KubaVymola/JFP_board_v2/schematic/JFP_board_v2_pcb_screenshot.png

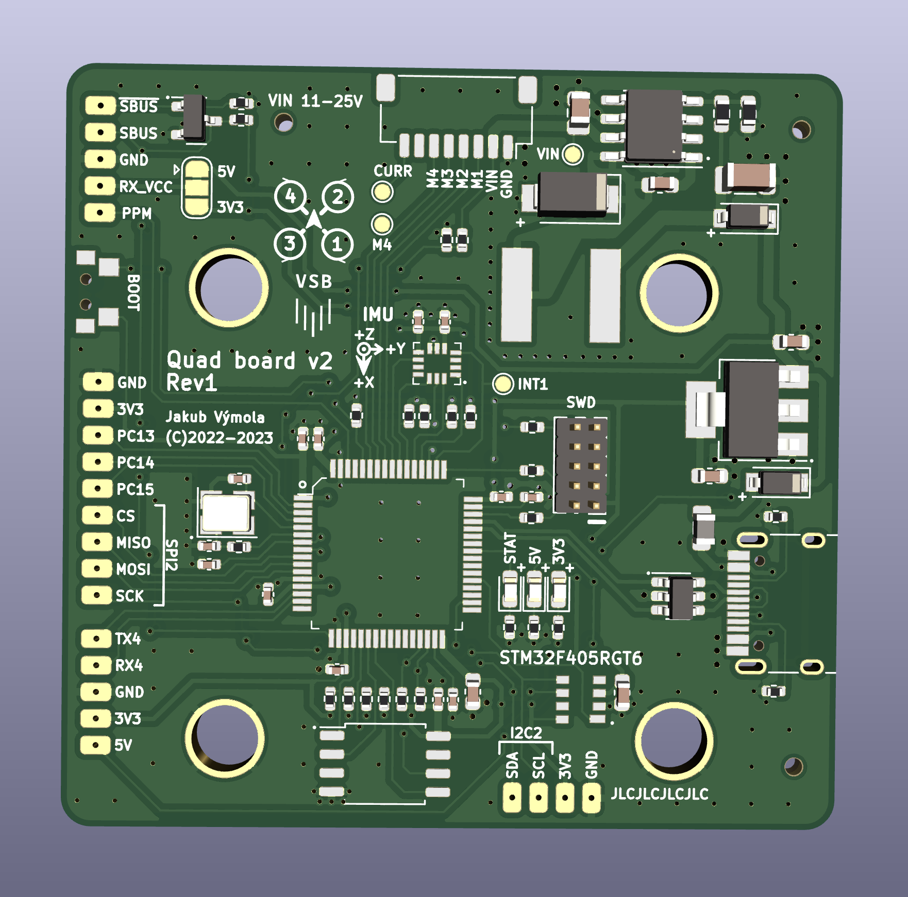
schematic/JFP_board_v2_pcb_screenshot.png
