KubaVymola/JFP_board_v2/orders/pcb_vym0038_13_1_2023.pdf

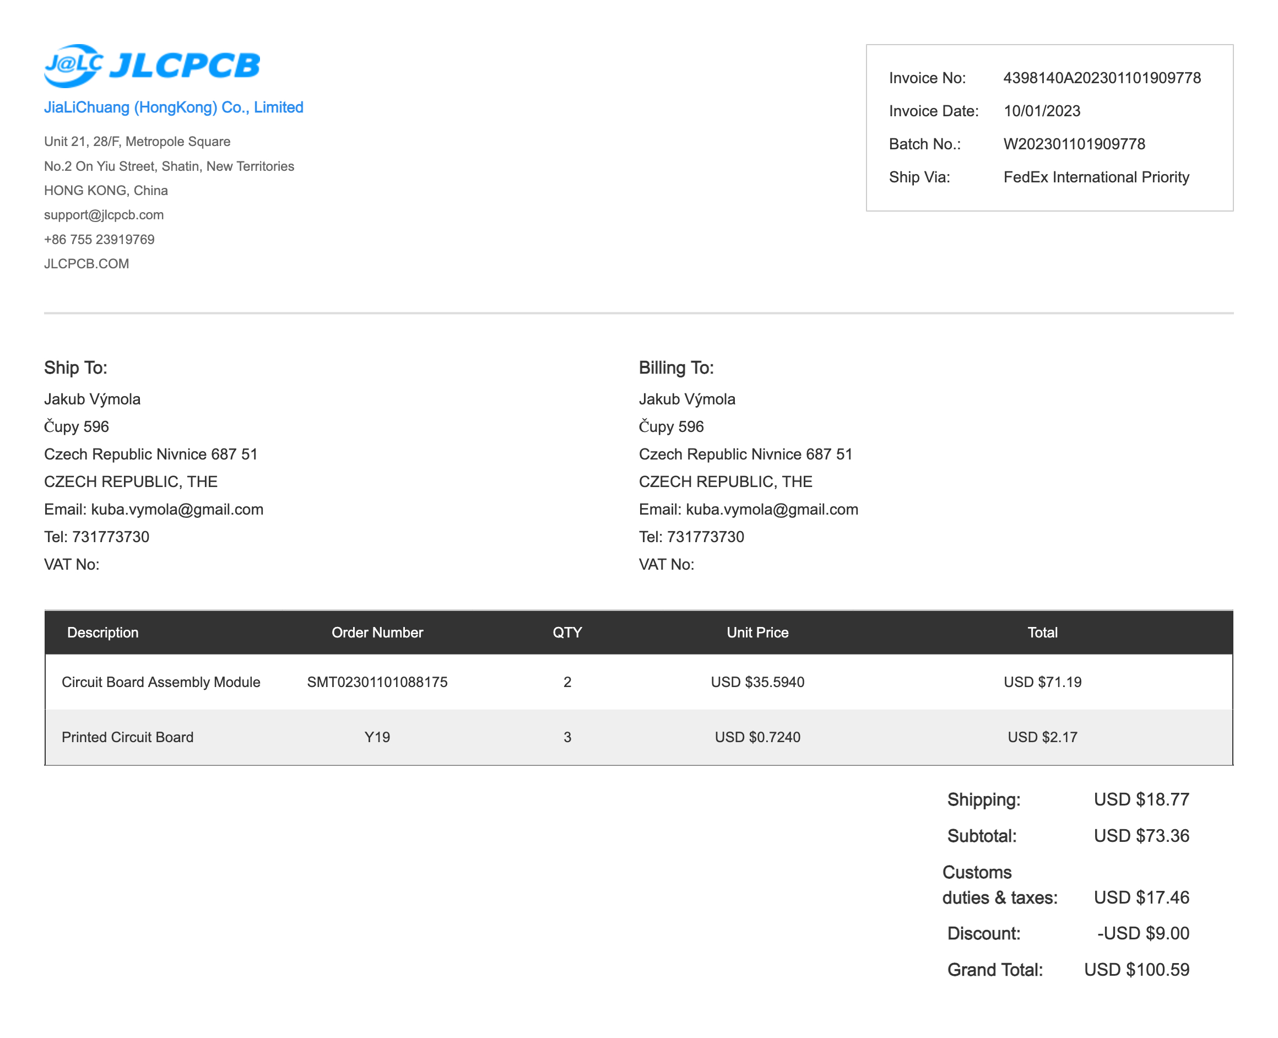
[picture p2: figure]
