KubaVymola/JFP_board_v2/schematic/JFP_board_v2.pdf

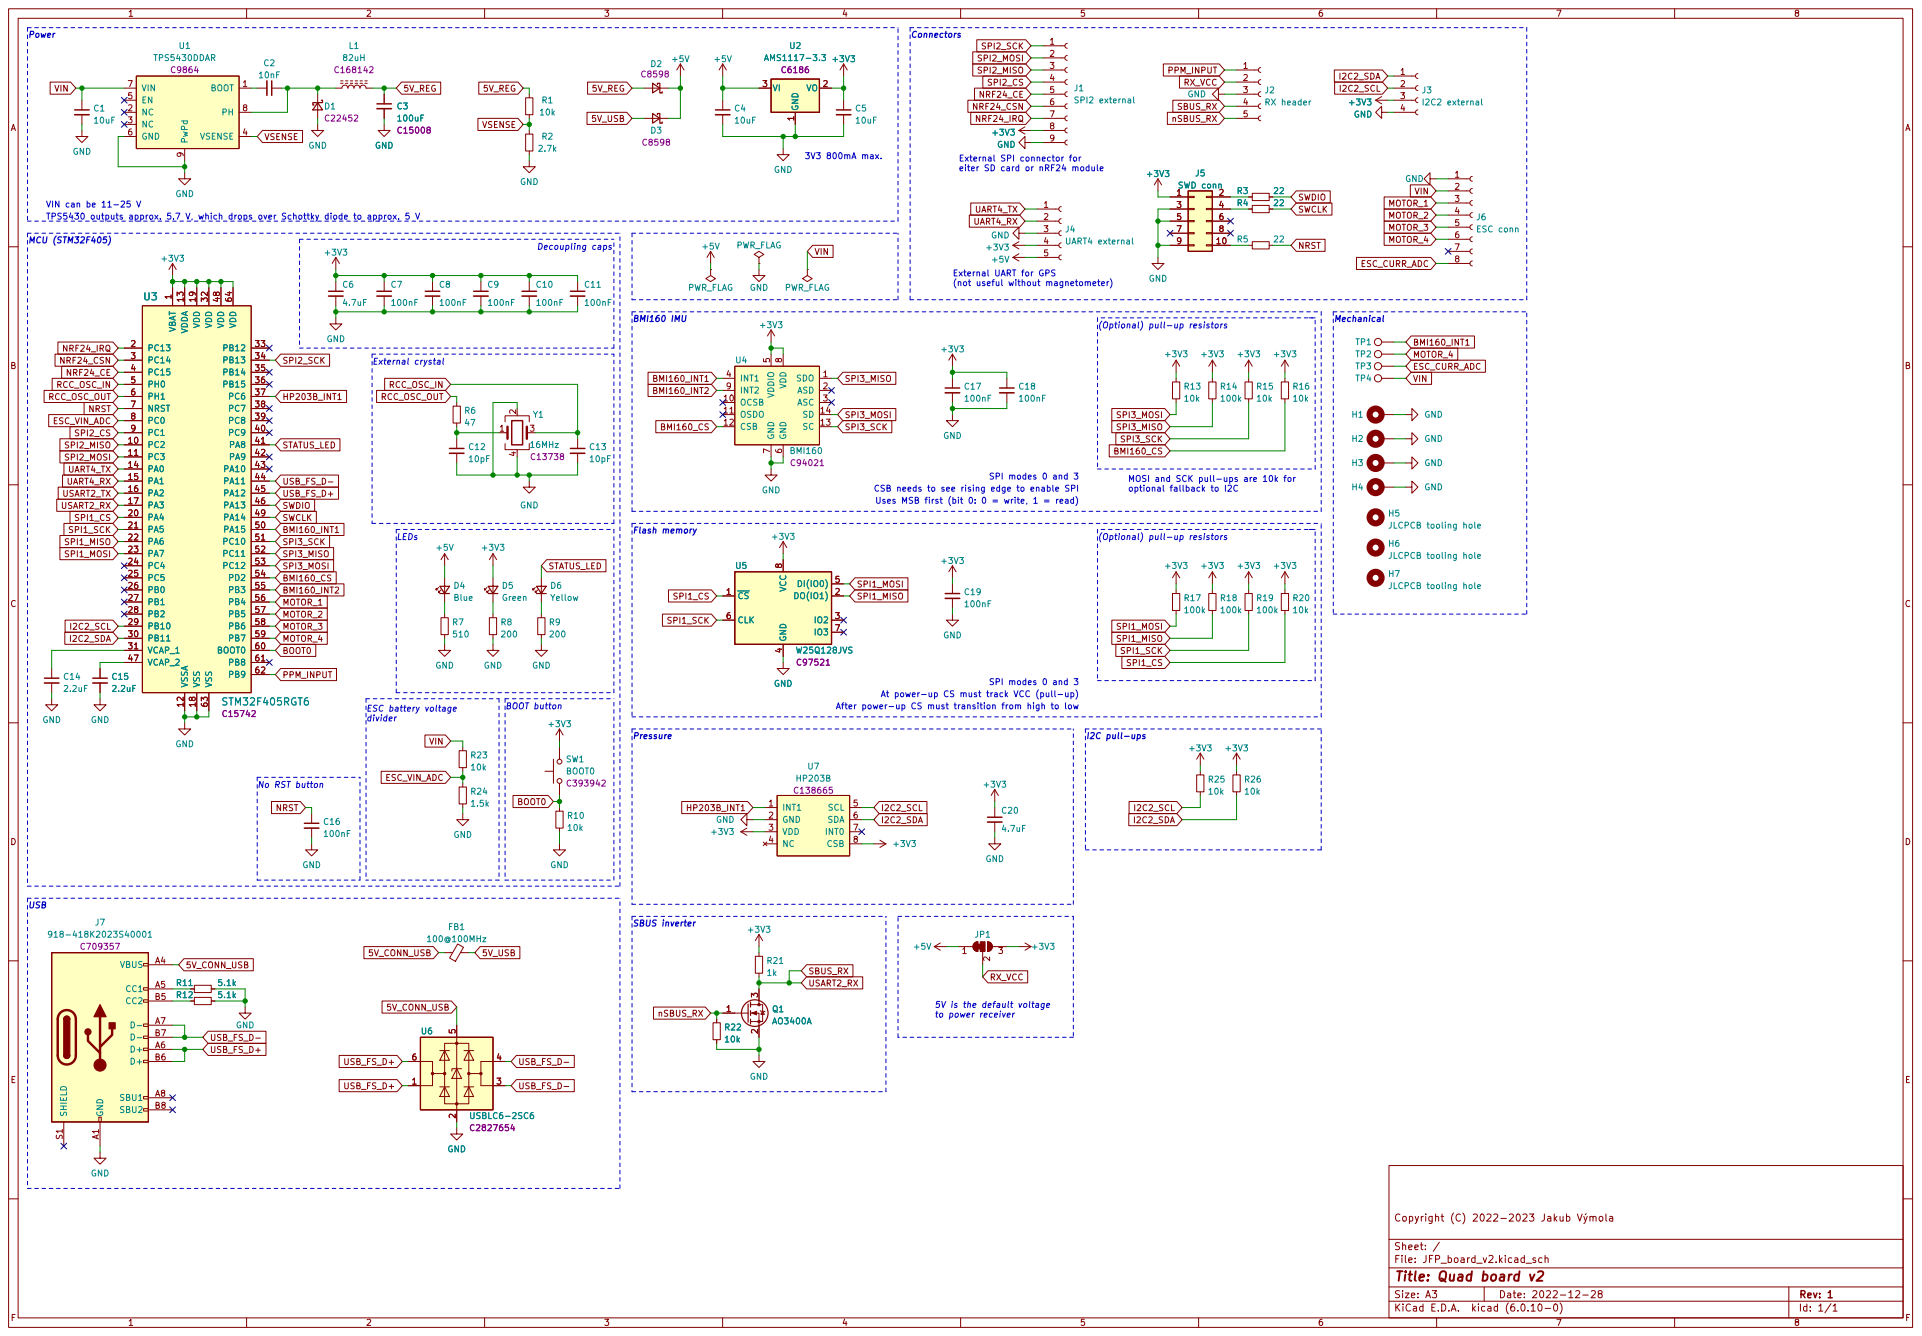
[picture p3: page 1]

1 VO 2 VI 3 +3V3 U5 W25Q128JVS C97521 ~{CS} 1 DO(IO1) 2

(not useful without magnetometer) External SPI connector for eiter SD card or nRF24 module CSB needs to see rising edge to enable SPI SPI modes 0 and 3

1 PC2 10 PC3 11 VSSA 12 VDDA 13 PA0 14 PA1 15 PA2 16 PA3 17 VSS 18 VDD 19 PC13 2 PA4 20 PA5 21 PA6 22 PA7 23 PC4 24 PC5 25 PB0 26 PB1 27 PB2 28 PB10 29 PC14 3 PB11 30 VCAP_1 31 VDD 32 PB12 33 PB13 34 PB14 35 PB15 36 PC6 37 PC7 38 PC8 39 PC15 4 PC9 40 PA8 41 PA9 42 PA10 43 PA11 44 PA12 45 PA13 46 VCAP_2 47 VDD 48 PA14 49 PH0 5 PA15 50 PC10 51 PC11 52 PC12 53 PD2 54 PB3 55 PB4 56 PB5 57 PB6 58 PB7 59 PH1 6 BOOT0 60 PB8 61 PB9 62 VSS 63 VDD 64 NRST 7 PC0 8 PC1 9 C3

VIN can be 11-25 V
TPS5430 outputs approx. 5.7 V, which drops over Schottky diode to approx. 5 V

5 5 | 6 6 R5 22
7 7 | 8 8

Uses MSB first (bit 0: 0 = write, 1 = read) External UART for GPS

1 PC2 10 PC3 11 VSSA 12 VDDA 13 PA0 14 PA1 15 PA2 16 PA3 17 VSS 18 VDD 19 PC13 2 PA4 20 PA5 21 PA6 22 PA7 23 PC4 24 PC5 25 PB0 26 PB1 27 PB2 28 PB10 29 PC14 3 PB11 30 VCAP_1 31 VDD 32 PB12 33 PB13 34 PB14 35 PB15 36 PC6 37 PC7 38 PC8 39 PC15 4 PC9 40 PA8 41 PA9 42 PA10 43 PA11 44 PA12 45 PA13 46 VCAP_2 47 VDD 48 PA14 49 PH0 5 PA15 50 PC10 51 PC11 52 PC12 53 PD2 54 PB3 55 PB4 56 PB5 57 PB6 58 PB7 59 PH1 6 BOOT0 60 PB8 61 PB9 62 VSS 63 VDD 64 NRST 7 PC0 8 PC1 9 U3 STM32F405RGT6 C15742

(Optional) pull-up resistors

5 GND
LEDs ESC battery voltage

MOSI and SCK pull-ups are 10k for
optional fallback to I2C

At power-up CS must track VCC (pull-up)

After power-up CS must transition from high to low

divider ESC_VIN_ADC | 1.5k GND | BOOT0

NRST

5V is the default voltage
to power receiver

Id: 1/1 Title: Quad board v2
