KubaVymola/JFP_board_v2/schematic/JFP_board_v2_pcb.pdf

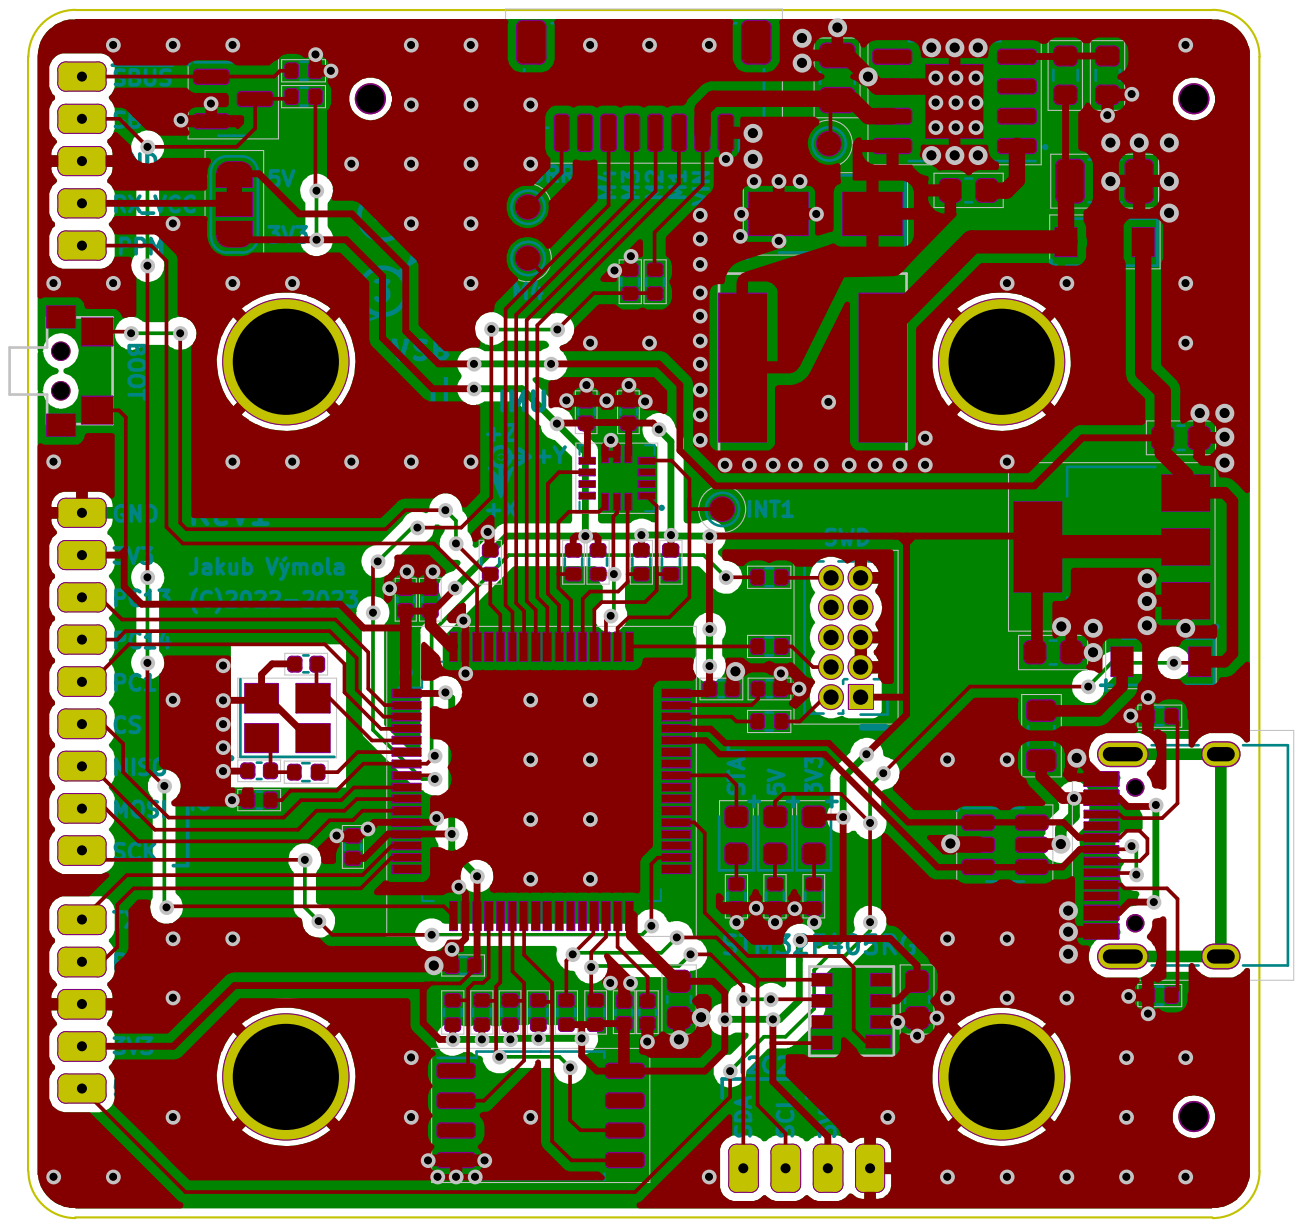
[picture p4: page 1]
