KubaVymola/JFP_board_v2/JFP_board_v2.kicad_pcb

## KiCad design JFP_board_v2.kicad_pcb (2023-02-23)

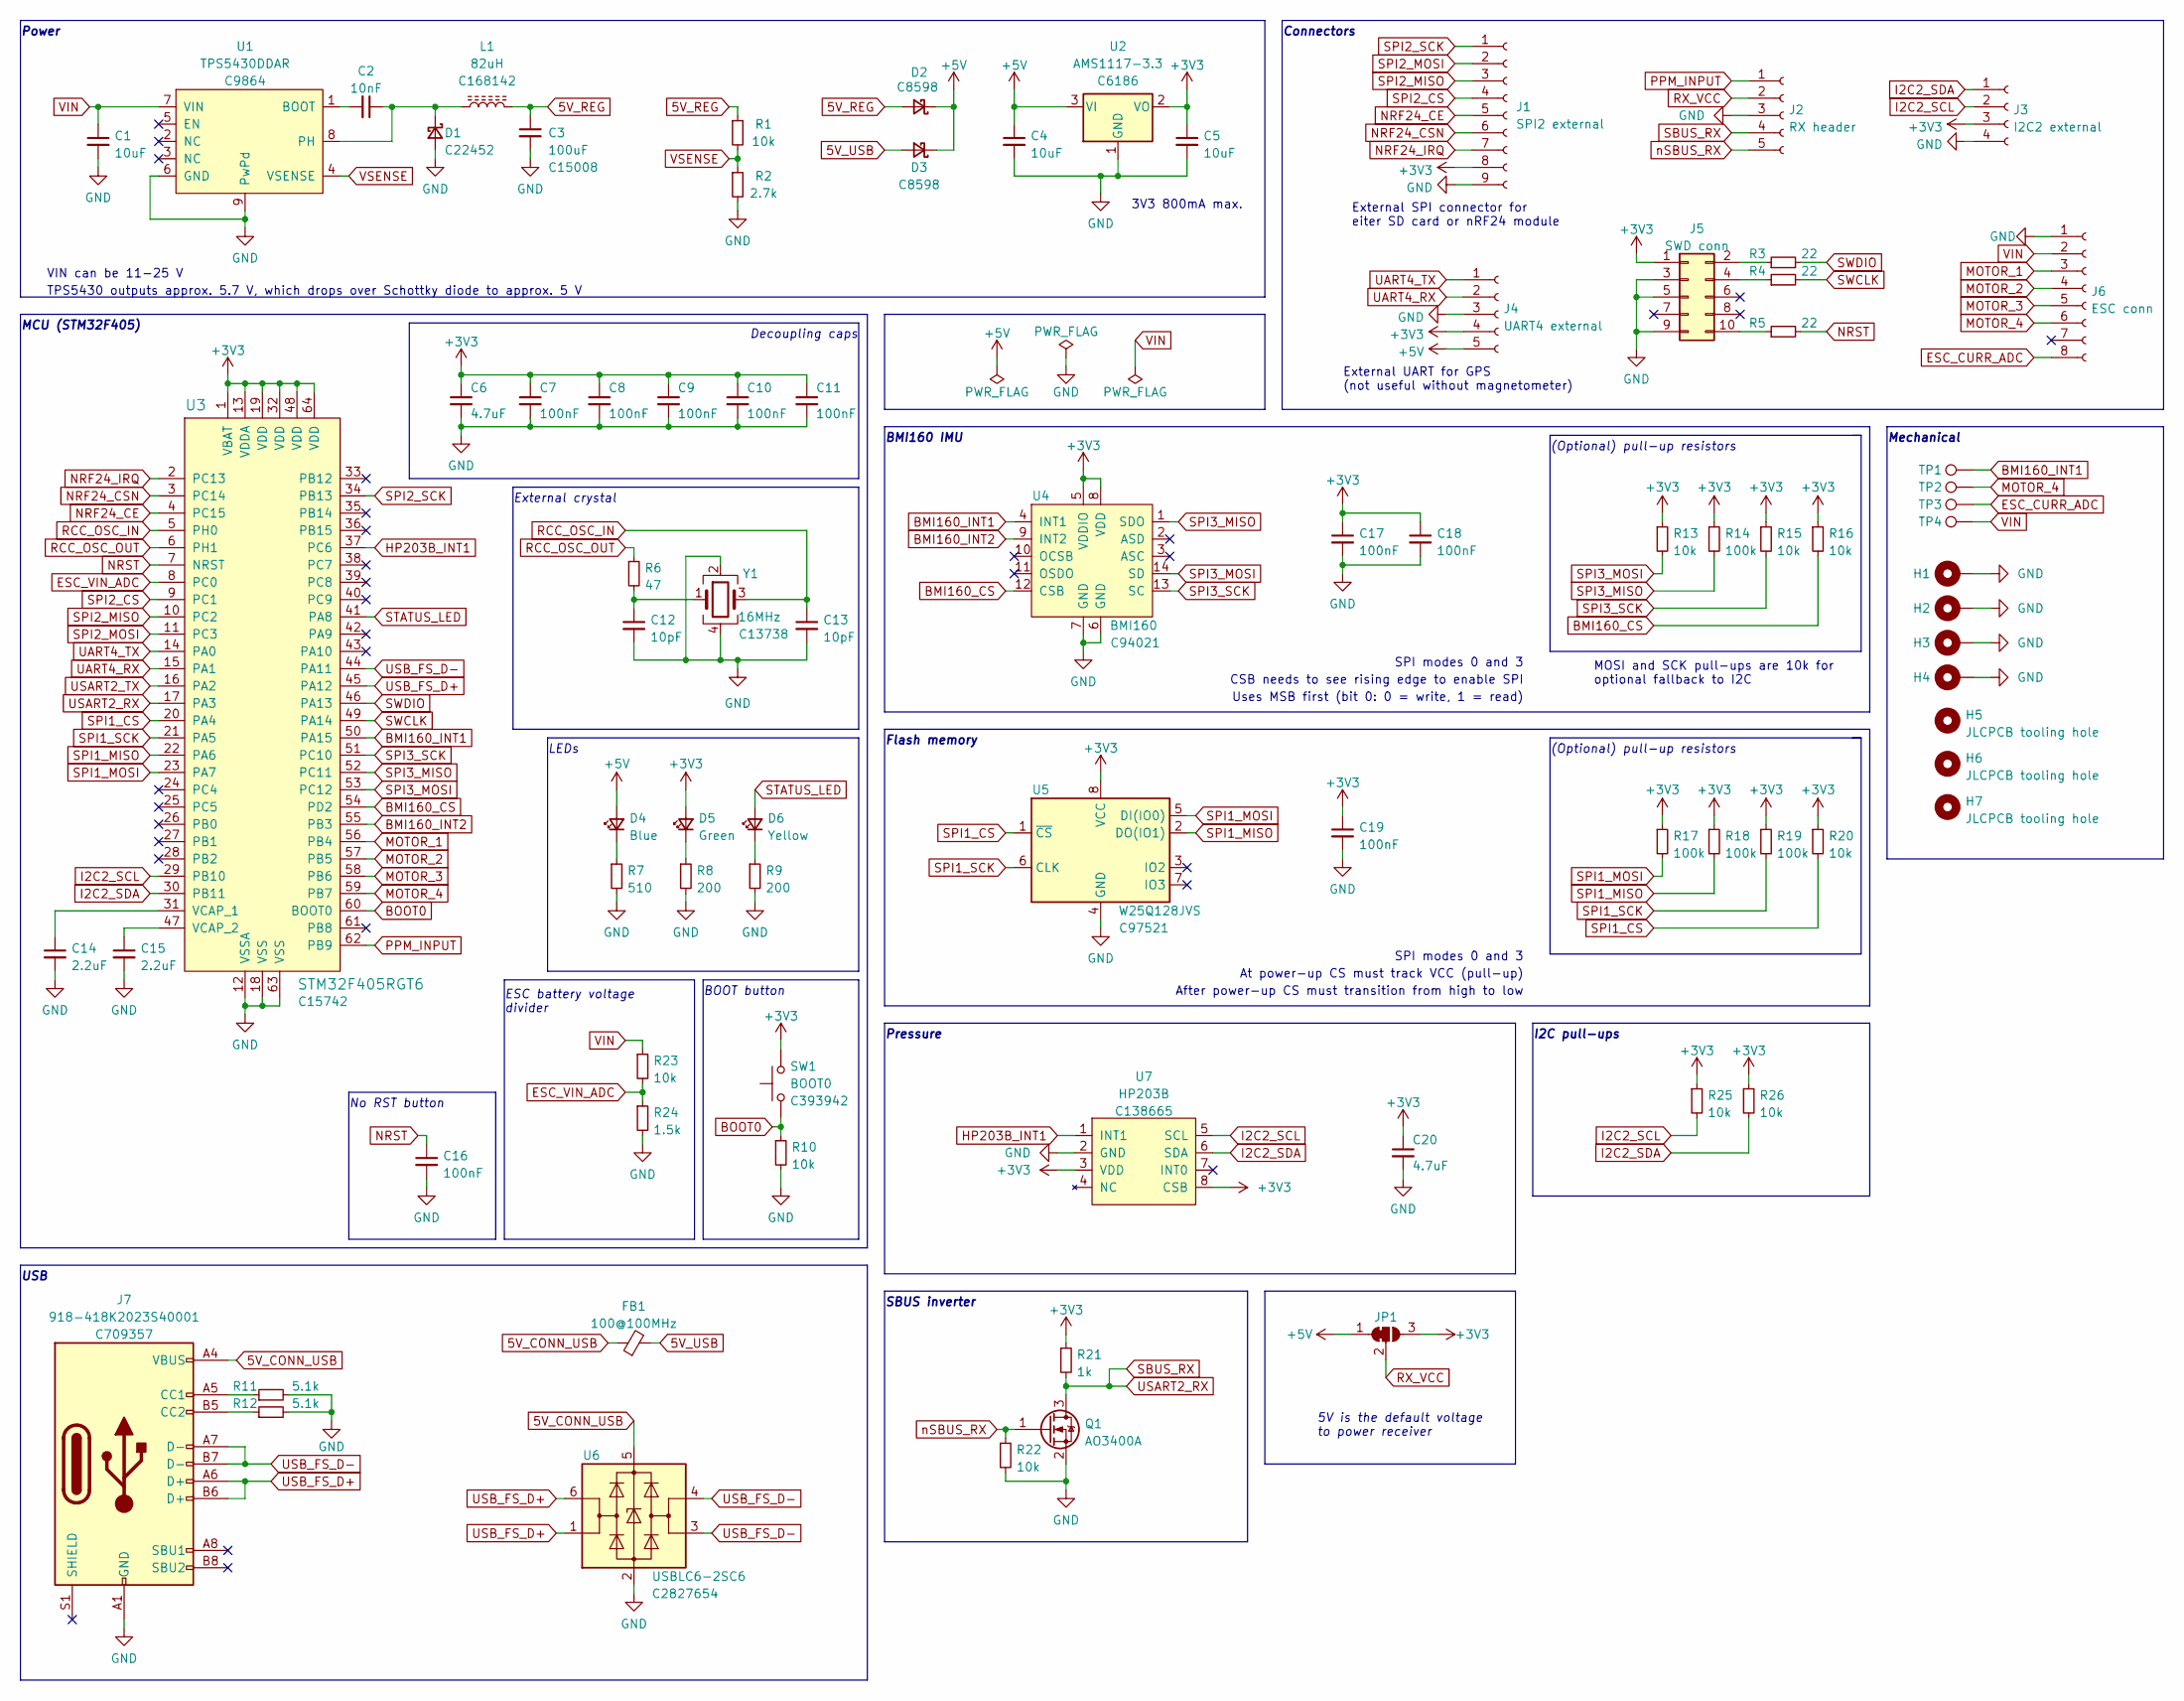
[picture p5: schematic JFP_board_v2.kicad_sch, Quad board v2]

Parts:
C1: 10uF; C_0805_2012Metric; LCSC C440198
C2: 10nF; C_0603_1608Metric; LCSC C57112
C3: 100uF; C_1206_3216Metric; LCSC C15008
C4, C5: 10uF; C_0603_1608Metric; LCSC C19702
C6, C20: 4.7uF; C_0603_1608Metric; LCSC C19666
C7, C8, C9, C10, C11, C16, C17, C18, C19: 100nF; C_0402_1005Metric; LCSC C307331
C12, C13: 10pF; C_0402_1005Metric; LCSC C32949
C14, C15: 2.2uF; C_0402_1005Metric; LCSC C12530
D1: D_Schottky_Small; D_SMA; LCSC C22452
D2, D3: D_Schottky_Small; D_SOD-123; LCSC C8598
D4: Blue; LED_0603_1608Metric; LCSC C72041
D5: Green; LED_0603_1608Metric; LCSC C72043
D6: Yellow; LED_0603_1608Metric; LCSC C72038
FB1: 100@100MHz; L_0805_2012Metric; LCSC C1015
H1, H2, H3, H4: MountingHole_Pad; Mounting_hole_GND_M3_4.5mm
H5, H6, H7: JLCPCB tooling hole; JLCPCB_tooling_hole_1.152mm
J1: SPI2 external; Pads_1.8mm_01x09
J2: RX header; Pads_1.8mm_01x05
J3: I2C2 external; Pads_1.8mm_01x04
J4: UART4 external; Pads_1.8mm_01x05
J5: SWD conn; PinHeader_2x05_P1.27mm_Vertical
J6: ESC conn; JST_SH_SM08B-SRSS-TB_1x08-1MP_P1.00mm_Horizontal
J7: 918-418K2023S40001; USB_C_Receptacle_HRO_TYPE-C-31-M-12; LCSC C709357
JP1: SolderJumper_3_Bridged12; SolderJumper-3_P1.3mm_Bridged12_RoundedPad1.0x1.5mm
L1: 82uH; SMD-8x8x4; LCSC C168142
Q1: AO3400A; SOT-23; LCSC C20917
R1: 10k; R_0603_1608Metric; LCSC C25804
R2: 2.7k; R_0603_1608Metric; LCSC C13167
R3, R4, R5: 22; R_0402_1005Metric; LCSC C25092
R6: 47; R_0402_1005Metric; LCSC C25118
R7: 510; R_0402_1005Metric; LCSC C25123
R8, R9: 200; R_0402_1005Metric; LCSC C25087
R10, R13, R15, R16, R20, R22, R23, R25, R26: 10k; R_0402_1005Metric; LCSC C25744
R11, R12: 5.1k; R_0402_1005Metric; LCSC C25905
R14, R17, R18, R19: 100k; R_0402_1005Metric; LCSC C25741
R21: 1k; R_0402_1005Metric; LCSC C11702
R24: 1.5k; R_0402_1005Metric; LCSC C25867
SW1: BOOT0; TS24CA; LCSC C393942
TP1, TP2, TP3, TP4: TestPoint; TestPoint_Pad_D1.0mm
U1: TPS5430DDAR; HSOP-8-1EP_3.9x4.9mm_P1.27mm_EP2.41x3.1mm; jlcpcb C9864
U2: AMS1117-3.3; SOT-223-3_TabPin2; LCSC C6186
U3: STM32F405RGT6; LQFP-64_10x10mm; MPN STM32F405RGT6; Digi-Key_PN 497-11767-ND
U4: BMI160; MPN BMI160; Digi-Key_PN 828-1057-1-ND
U5: W25Q128JVS; SOIC-8_5.23x5.23mm_P1.27mm; LCSC C97521
U6: USBLC6-2SC6; SOT-23-6; LCSC C2827654
U7: HP203B; LGA-8_3.6x3.8x0.9P; LCSC C138665
Y1: 16MHz; Crystal_SMD_3225-4Pin_3.2x2.5mm; LCSC C13738

Connections:
5V_CONN_USB: FB1.1, J7.A4 (VBUS), J7.A9 (VBUS), J7.B4 (VBUS), J7.B9 (VBUS), U6.5 (VBUS)
5V_REG: C3.1, D2.2 (A), L1.2, R1.1
5V_USB: D3.2 (A), FB1.2
+3V3: C5.1, C6.1, C7.1, C8.1, C9.1, C10.1, C11.1, C17.1, C18.1, C19.1, C20.1, D5.2 (A), J1.8, J3.3, J4.4, J5.1, JP1.3 (B), R13.1, R14.1, R15.1, R16.1, R17.1, R18.1, R19.1, R20.1, R21.1, R25.1, R26.1, SW1.2, U2.2 (VO), U3.1 (VBAT), U3.13 (VDDA), U3.19 (VDD), U3.32 (VDD), U3.48 (VDD), U3.64 (VDD), U4.5 (VDDIO), U4.8 (VDD), U5.8 (VCC), U7.3 (VDD), U7.8 (CSB)
+5V: C4.1, D2.1 (K), D3.1 (K), D4.2 (A), J4.5, JP1.1 (A), U2.3 (VI)
BMI160_CS: R16.2, U3.54 (PD2), U4.12 (CSB)
BMI160_INT1: TP1.1, U3.50 (PA15), U4.4 (INT1)
BMI160_INT2: U3.55 (PB3), U4.9 (INT2)
BOOT0: R10.1, SW1.1, U3.60 (BOOT0)
ESC_CURR_ADC: J6.8, TP3.1
ESC_VIN_ADC: R23.2, R24.1, U3.8 (PC0)
GND: C1.2, C3.2, C4.2, C5.2, C6.2, C7.2, C8.2, C9.2, C10.2, C11.2, C12.2, C13.2, C14.2, C15.2, C16.2, C17.2, C18.2, C19.2, C20.2, D1.2 (A), H1.1, H2.1, H3.1, H4.1, J1.9, J2.3, J3.4, J4.3, J5.3, J5.5, J5.9, J6.1, J7.A1 (GND), J7.A12 (GND), J7.B1 (GND), J7.B12 (GND), Q1.2 (S), R2.2, R7.2, R8.2, R9.2, R10.2, R11.2, R12.2, R22.2, R24.2, U1.6 (GND), U1.9 (PwPd), U2.1 (GND), U3.12 (VSSA), U3.18 (VSS), U3.63 (VSS), U4.6 (GND), U4.7 (GND), U5.4 (GND), U6.2 (GND), U7.2 (GND), Y1.2, Y1.4
HP203B_INT1: U3.37 (PC6), U7.1 (INT1)
I2C2_SCL: J3.2, R25.2, U3.29 (PB10), U7.5 (SCL)
I2C2_SDA: J3.1, R26.2, U3.30 (PB11), U7.6 (SDA)
MOTOR_1: J6.3, U3.56 (PB4)
MOTOR_2: J6.4, U3.57 (PB5)
MOTOR_3: J6.5, U3.58 (PB6)
MOTOR_4: J6.6, TP2.1, U3.59 (PB7)
NRF24_CE: J1.5, U3.4 (PC15)
NRF24_CSN: J1.6, U3.3 (PC14)
NRF24_IRQ: J1.7, U3.2 (PC13)
NRST: C16.1, R5.2, U3.7 (NRST)
unnamed: C2.1, D1.1 (K), L1.1, U1.8 (PH)
unnamed: C2.2, U1.1 (BOOT)
unnamed: C12.1, R6.2, Y1.1
unnamed: C14.1, U3.31 (VCAP_1)
unnamed: C15.1, U3.47 (VCAP_2)
unnamed: D4.1 (K), R7.1
unnamed: D5.1 (K), R8.1
unnamed: D6.1 (K), R9.1
unnamed: J5.2, R3.1
unnamed: J5.4, R4.1
unnamed: J5.10, R5.1
unnamed: J7.A5 (CC1), R11.1
unnamed: J7.B5 (CC2), R12.1
PPM_INPUT: J2.1, U3.62 (PB9)
RCC_OSC_IN: C13.1, U3.5 (PH0), Y1.3
RCC_OSC_OUT: R6.1, U3.6 (PH1)
RX_VCC: J2.2, JP1.2 (C)
SBUS_RX: J2.4, Q1.3 (D), R21.2, U3.17 (PA3)
SPI1_CS: R20.2, U3.20 (PA4), U5.1 (~CS)
SPI1_MISO: R18.2, U3.22 (PA6), U5.2 (DO(IO1))
SPI1_MOSI: R17.2, U3.23 (PA7), U5.5 (DI(IO0))
SPI1_SCK: R19.2, U3.21 (PA5), U5.6 (CLK)
SPI2_CS: J1.4, U3.9 (PC1)
SPI2_MISO: J1.3, U3.10 (PC2)
SPI2_MOSI: J1.2, U3.11 (PC3)
SPI2_SCK: J1.1, U3.34 (PB13)
SPI3_MISO: R14.2, U3.52 (PC11), U4.1 (SDO)
SPI3_MOSI: R13.2, U3.53 (PC12), U4.14 (SD)
SPI3_SCK: R15.2, U3.51 (PC10), U4.13 (SC)
STATUS_LED: D6.2 (A), U3.41 (PA8)
SWCLK: R4.2, U3.49 (PA14)
SWDIO: R3.2, U3.46 (PA13)
UART4_RX: J4.2, U3.15 (PA1)
UART4_TX: J4.1, U3.14 (PA0)
USART2_TX: U3.16 (PA2)
USB_FS_D+: J7.A6 (D+), J7.B6 (D+), U3.45 (PA12), U6.1 (I/O1), U6.6 (I/O1)
USB_FS_D-: J7.A7 (D-), J7.B7 (D-), U3.44 (PA11), U6.3 (I/O2), U6.4 (I/O2)
VIN: C1.1, J6.2, R23.1, TP4.1, U1.7 (VIN)
VSENSE: R1.2, R2.1, U1.4 (VSENSE)
nSBUS_RX: J2.5, Q1.1 (G), R22.1

Notes on the sheet:
SPI modes 0 and 3
Decoupling caps
Flash memory
CSB needs to see rising edge to enable SPI
At power-up CS must track VCC (pull-up)
VIN can be 11-25 V
MCU (STM32F405)
USB
Uses MSB first (bit 0: 0 = write, 1 = read)
SBUS inverter
LEDs
3V3 800mA max.
External SPI connector for eiter SD card or nRF24 module
TPS5430 outputs approx. 5.7 V, which drops over Schottky diode to approx. 5 V
5V is the default voltage to power receiver
BMI160 IMU
(Optional) pull-up resistors
No RST button
ESC battery voltage divider
Pressure
Connectors
BOOT button
I2C pull-ups
After power-up CS must transition from high to low
External crystal
Power
Mechanical
External UART for GPS (not useful without magnetometer)
MOSI and SCK pull-ups are 10k for optional fallback to I2C

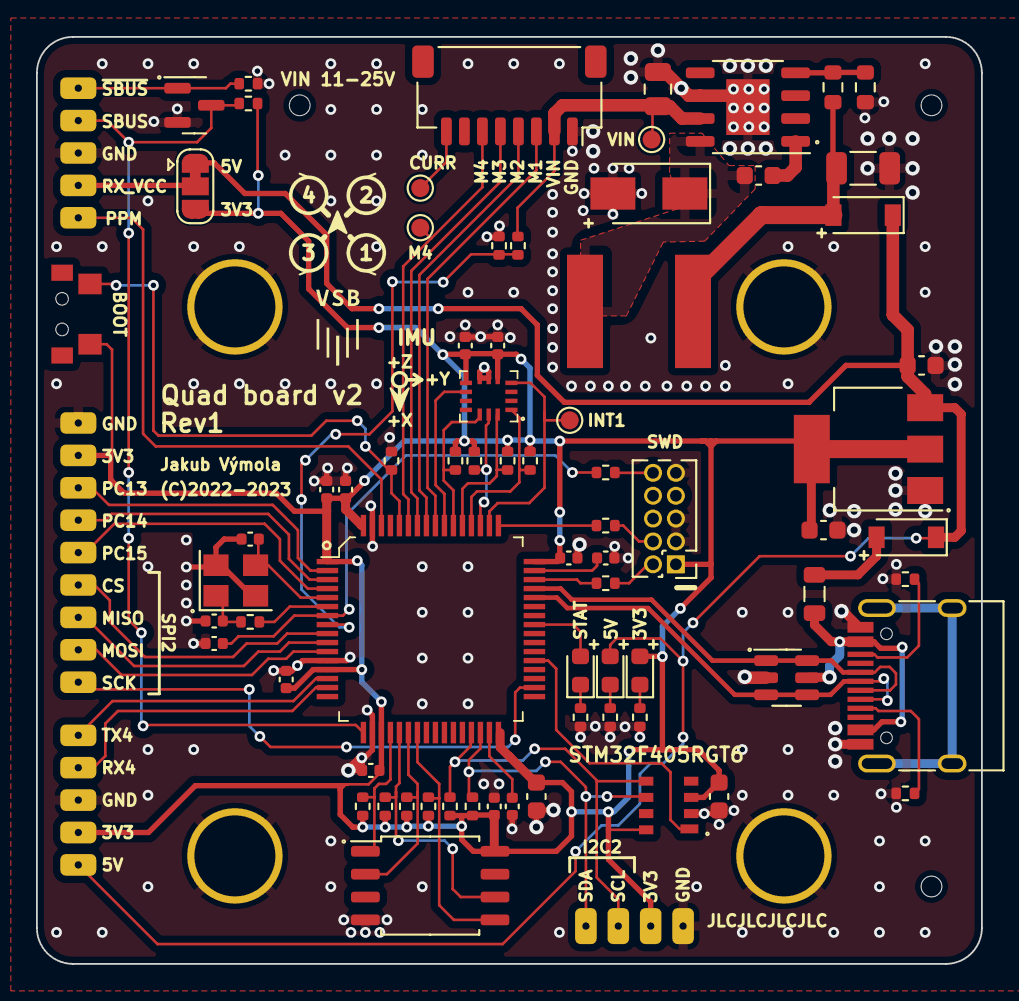
[picture p6: board JFP_board_v2.kicad_pcb from above]

Board: 2 copper layers, 52.5 x 51.5 mm, 86 parts (0 on the bottom side), 62 nets.

Other parts of the board:
REFBMIAXES: BMI_160_axes
REFQUAD: Drone_props
REFVSBLOGO: d2f2efcc-2693-47d5-a2c4-dd12ed3edea1
