KubaVymola/JFP_board_v2/(commit log)

2023-01-05 Added HP203B pressure sensor
    [JFP_board_v2-BOM.csv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]
2023-02-23 Production files
    [JFP_board_v2-BOM.csv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]
