KubaVymola/JFP_board_v2/(notices)

Notices in the files:
JFP_board_v2.kicad_sch:
Copyright (C) 2022-2023 Jakub Výmola
JFP_board_v2.kicad_pcb:
(C)2022-2023
